radiant803/pluto-drone-petg-frame/out/pluto_canopy_flat.stl

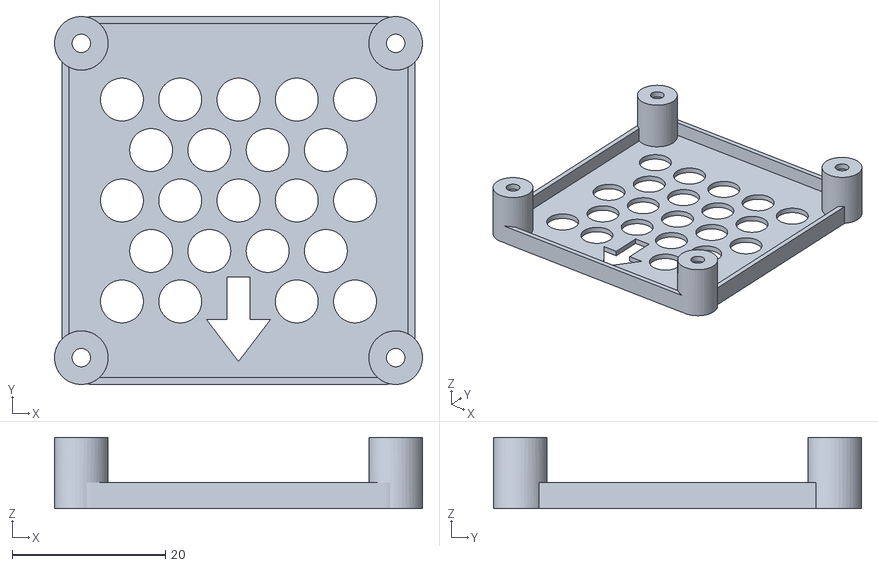
[picture p5: CAD file, 2026-10-21]
out/pluto_canopy_flat.stl
48.0 x 48.0 x 9.30
