radiant803/pluto-drone-petg-frame/out/pluto_frame.step

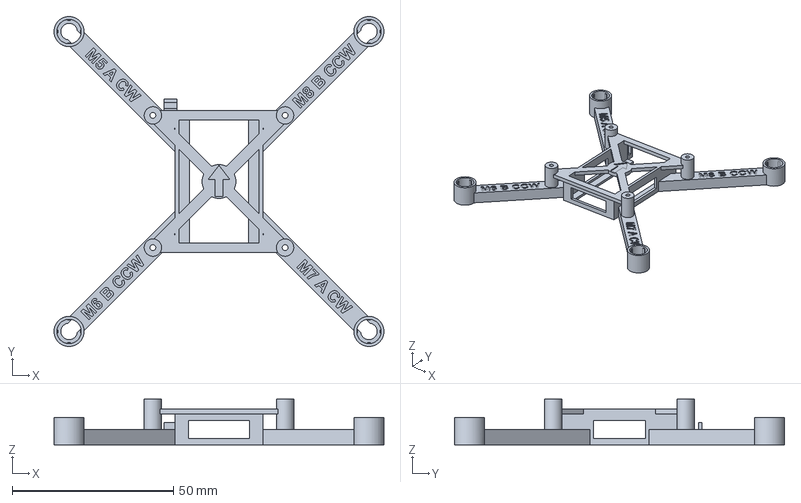
[picture p6: CAD file, 2026-10-21]
out/pluto_frame.step
102.3 x 102.3 x 14.2 mm
