radiant803/pluto-drone-petg-frame/out/motor_fit_coupon.step

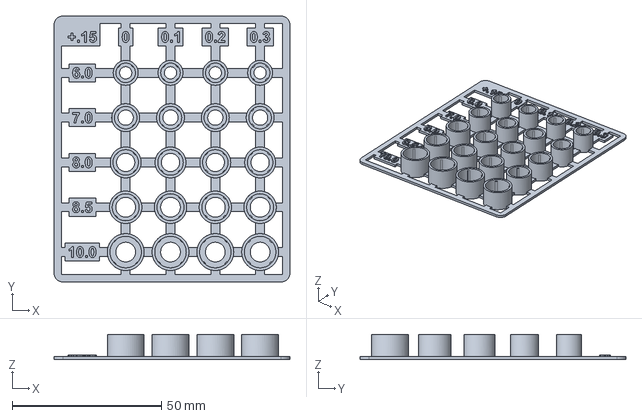
[picture p7: CAD file, 2026-10-21]
out/motor_fit_coupon.step
79.0 x 89.0 x 8.50 mm
