radiant803/pluto-drone-petg-frame/(list of files, cad)

Other CAD files:
out/motor_fit_coupon.3mf
out/motor_fit_coupon.stl
out/pluto_frame.3mf
out/pluto_frame.stl
