radiant803/pluto-drone-petg-frame/(commit log)

2026-10-21 Pluto 1.2 PETG replacement frame (0720 motors) + motor fit coupon
    One-piece printable frame for the Drona Aviation Pluto 1.2 that reuses the stock
    Primus V5, dampers, screws, motors, props, battery and canopy. Motor tubes and the
    fit coupon carry a +0.15 mm printed-hole shrink allowance from a fit test
    (see docs/TOLERANCES.md). Parametric build123d source, design checks, simulation
    and Bambu P1S print settings included.
    [motor_fit_coupon.3mf, motor_fit_coupon.step, motor_fit_coupon.stl, pluto_frame.3mf, pluto_frame.step, pluto_frame.stl]
2026-10-21 Document compatibility: v1 is for a plain Pluto 1.2, add-on modules not yet supported
    Adds docs/COMPATIBILITY.md and a README section: the frame has no mounting
    points, cable routing or strain relief for add-on modules, so a module may work
    but may load the board and its connectors (damper isolation, thrust margin,
    balance, prop clearance). Includes interim precautions and the roadmap for
    module support in future versions.
2026-10-21 Add flat vented canopy (out/pluto_canopy_flat.stl)
    Flat PETG canopy that attaches to the stock screws and dampers. Prints roof-down
    with no supports and no brim (about 14 min, 2.9 g on a P1S).
    [pluto_canopy_flat.stl]
2026-10-21 Add source for the flat canopy (src/p_canopy_flat.py)
    Parametric build for out/pluto_canopy_flat.stl: rebuilds to within 0.02% of the
    exported STL volume. Needs p_params.py and p_asm.py.
